CoreElectronics/CE-PiicoDev-Ultrasonic-Rangefinder/README.md

# PiicoDev® Ultrasonic Rangefinder
This is the repo for the Core Electronics [PiicoDev Ultrasonic Rangefinder](https://core-electronics.com.au/catalog/product/view/sku/CE09360).

## License
This project is open source - please review the LICENSE.md file for further licensing information.

If you have any technical questions, or concerns about licensing, please contact technical support on the [Core Electronics forums](https://forum.core-electronics.com.au/).

*\"PiicoDev\" and the PiicoDev logo are trademarks of Core Electronics Pty Ltd.*
