CoreElectronics/CE-PiicoDev-Ultrasonic-Rangefinder/CAD/RCWL-1601.step

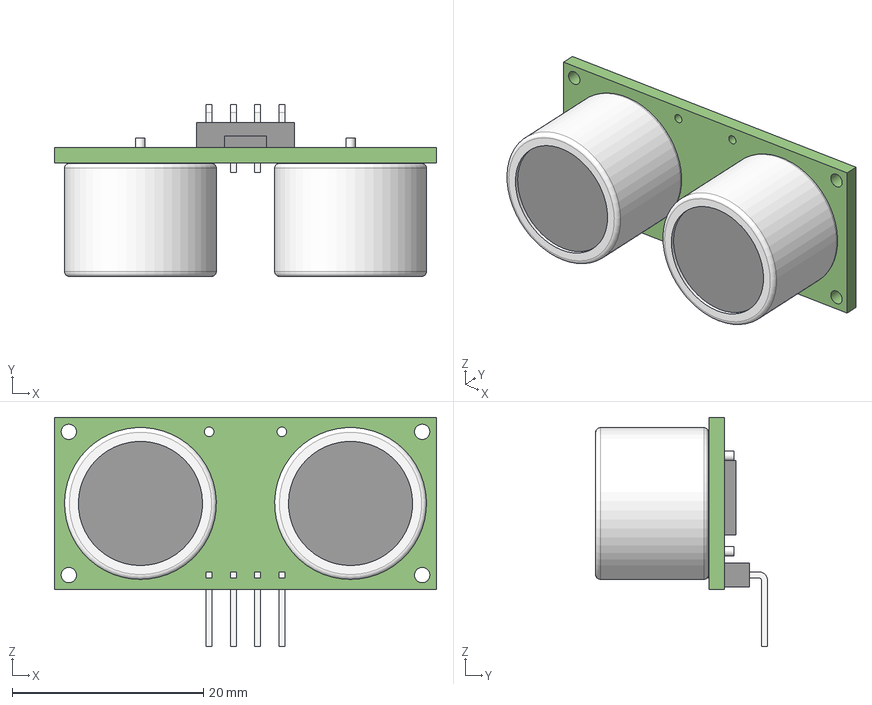
[picture p1: CAD file, 2022-12-01]
CAD/RCWL-1601.step
40.0 x 18.0 x 24.0 mm
