CoreElectronics/CE-PiicoDev-Ultrasonic-Rangefinder/Documents/schematic.pdf

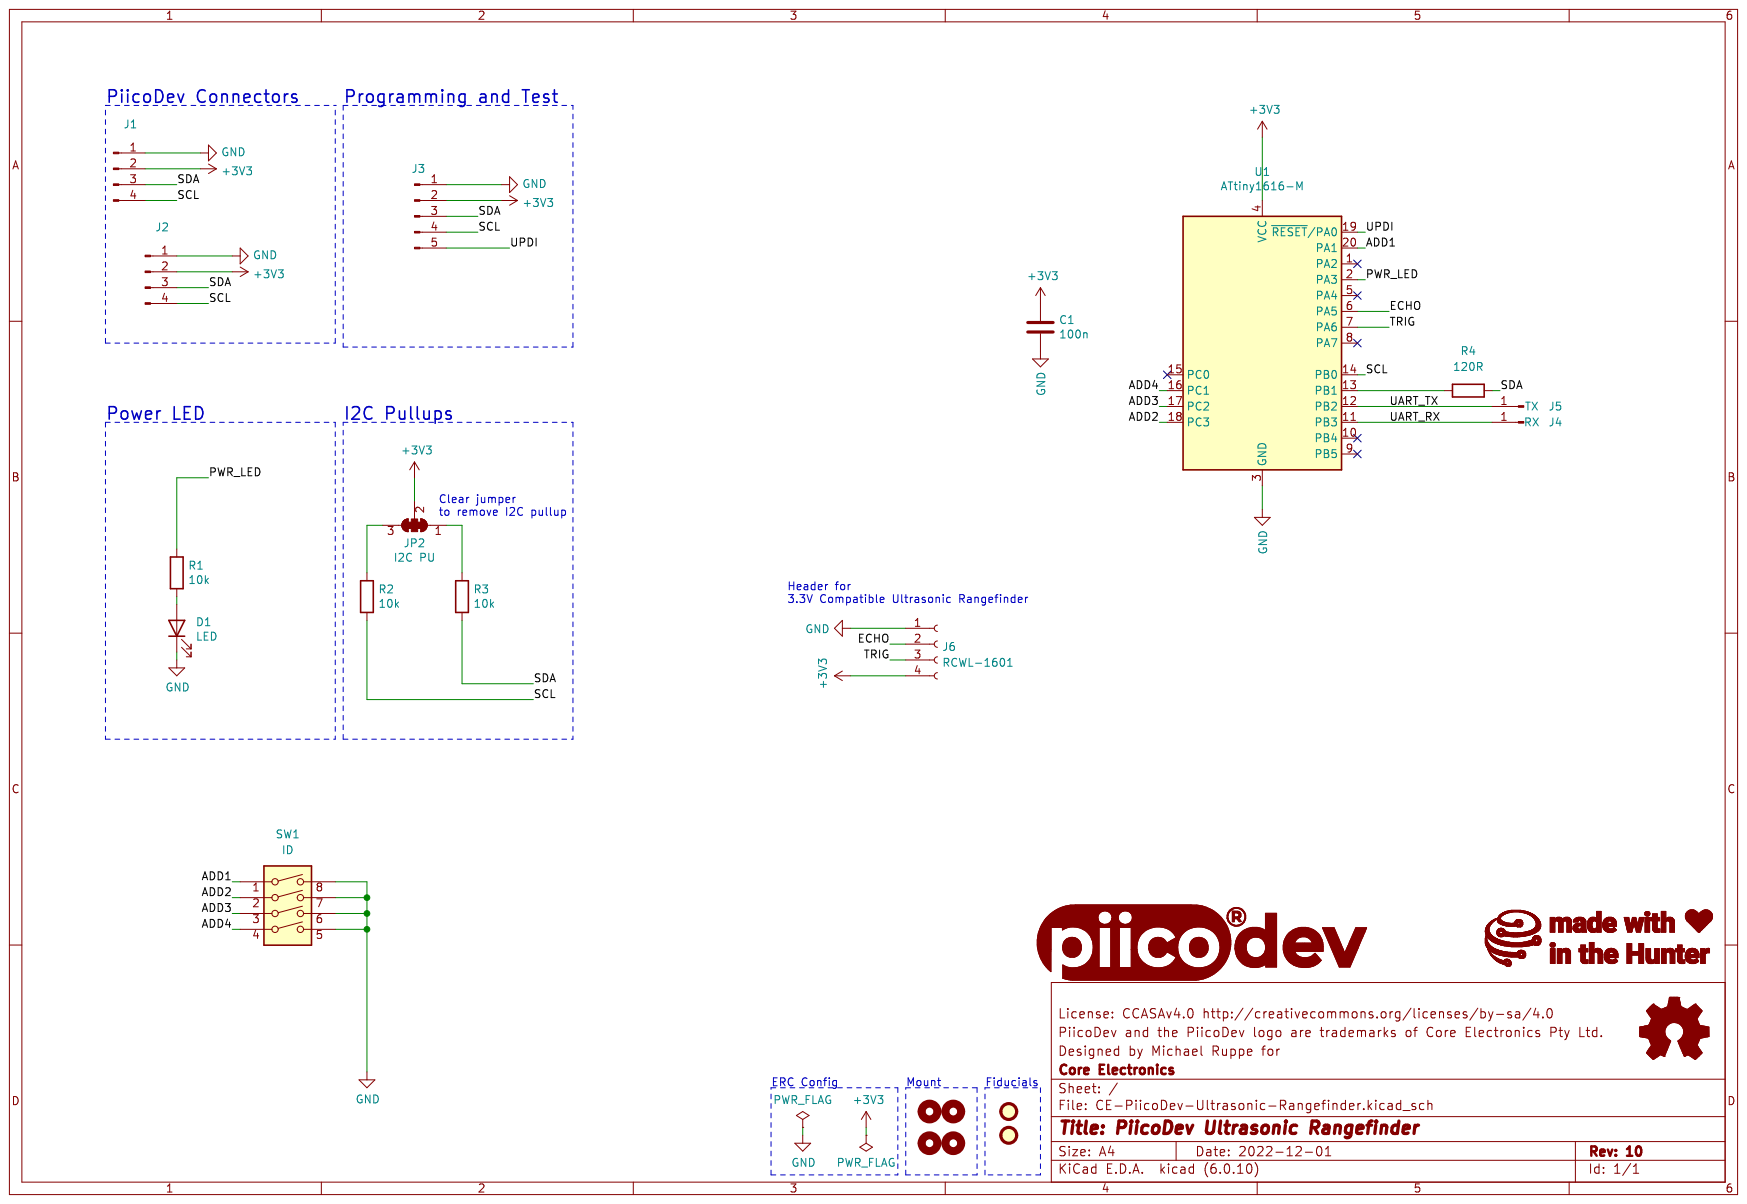
[picture p2: page 1]
