CoreElectronics/CE-PiicoDev-Ultrasonic-Rangefinder/(commit log)

2022-12-01 v00 prototype
    [CE-PiicoDev-Ultrasonic-Rangefinder.kicad_pcb, CE-PiicoDev-Ultrasonic-Rangefinder.kicad_sch]
2022-12-01 v02 fix program/test test points
    [CE-PiicoDev-Ultrasonic-Rangefinder.kicad_pcb, RCWL-1601.step]
2025-11-26 Swapped for THT Header, adjusted artwork
    [CE-PiicoDev-Ultrasonic-Rangefinder.kicad_pcb, CE-PiicoDev-Ultrasonic-Rangefinder.kicad_sch]
2026-01-30 Using new pogo design
    [CE-PiicoDev-Ultrasonic-Rangefinder.kicad_pcb, CE-PiicoDev-Ultrasonic-Rangefinder.kicad_sch]
2026-04-21 Programming Footprint compliant
    [CE-PiicoDev-Ultrasonic-Rangefinder.kicad_pcb, CE-PiicoDev-Ultrasonic-Rangefinder.kicad_sch]
