CoreElectronics/CE-PiicoDev-Ultrasonic-Rangefinder/(notices)

Notices in the files:
PCB/CE-PiicoDev-Ultrasonic-Rangefinder.kicad_sch:
License: CCASAv4.0 http://creativecommons.org/licenses/by-sa/4.0
